Skyslycer/SolarEInk/cad/case_shell.step

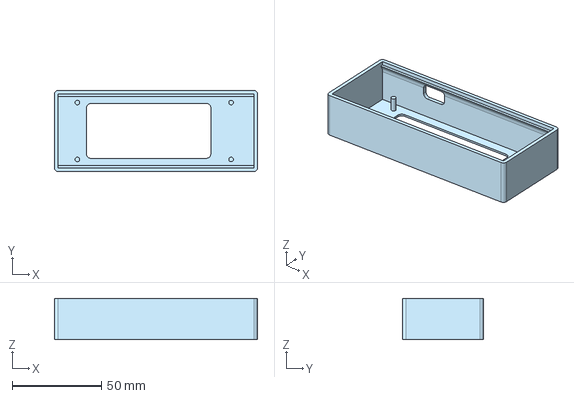
[picture p10: CAD file, 2026-10-25]
cad/case_shell.step
113.7 x 45.5 x 23.0 mm
