Skyslycer/SolarEInk/cad/holder.step

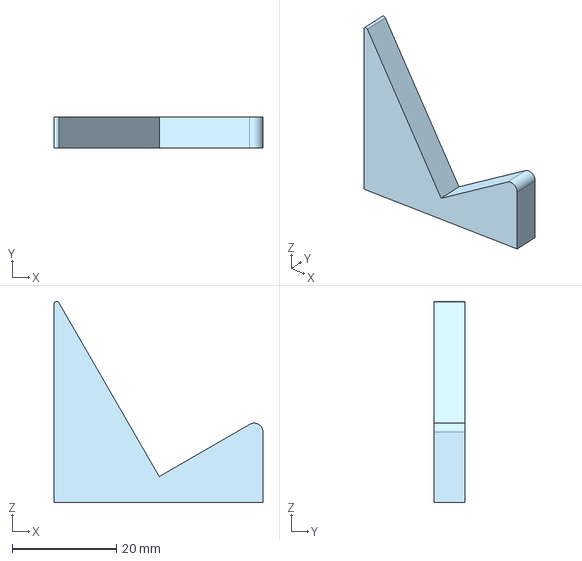
[picture p11: CAD file, 2026-10-25]
cad/holder.step
40.1 x 6.00 x 38.6 mm
