Skyslycer/SolarEInk/cad/case_lid.step

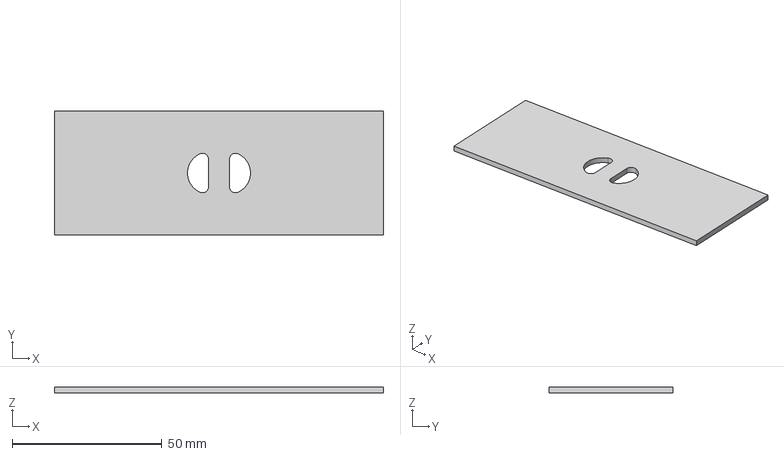
[picture p12: CAD file, 2026-10-25]
cad/case_lid.step
109.7 x 41.5 x 2.00 mm
