Skyslycer/SolarEInk/(list of files, cad)

Other CAD files:
cad/case_lid.stl
cad/case_shell.stl
cad/holder.stl
