Skyslycer/SolarEInk/scripts/generate_fonts.py

"""Generate GFX fonts from explicit pixel glyphs; no font rasterization/resizing.

Each # is an actual screen pixel at 1x. Larger glyphs use exact integer
multiples, preserving symmetric shapes, open counters and even strokes.
0x7f is the degree sign in the dashboard's single-byte text encoding.
"""
from pathlib import Path

patterns = {
    ' ': ['...'] * 7,
    '!': ['#','#','#','#','#','.','#'],
    '%': ['##..#','##..#','...#.','..#..','.#...','#..##','#..##'],
    '-': ['.....','.....','.....','#####','.....','.....','.....'],
    '.': ['.','.','.','.','.','#','#'],
    '/': ['....#','....#','...#.','..#..','.#...','#....','#....'],
    ':': ['.','#','#','.','#','#','.'],
    '?': ['.###.','#...#','....#','...#.','..#..','.....','..#..'],
    '0': ['.###.','#...#','#...#','#...#','#...#','#...#','.###.'],
    '1': ['..#..','.##..','..#..','..#..','..#..','..#..','.###.'],
    '2': ['.###.','#...#','....#','...#.','..#..','.#...','#####'],
    '3': ['####.','....#','....#','.###.','....#','....#','####.'],
    '4': ['...#.','..##.','.#.#.','#..#.','#####','...#.','...#.'],
    '5': ['#####','#....','#....','####.','....#','....#','####.'],
    '6': ['.###.','#....','#....','####.','#...#','#...#','.###.'],
    '7': ['#####','....#','...#.','..#..','.#...','.#...','.#...'],
    '8': ['.###.','#...#','#...#','.###.','#...#','#...#','.###.'],
    '9': ['.###.','#...#','#...#','.####','....#','....#','.###.'],
    'A': ['.###.','#...#','#...#','#####','#...#','#...#','#...#'],
    'B': ['####.','#...#','#...#','####.','#...#','#...#','####.'],
    'C': ['.####','#....','#....','#....','#....','#....','.####'],
    'D': ['####.','#...#','#...#','#...#','#...#','#...#','####.'],
    'E': ['#####','#....','#....','####.','#....','#....','#####'],
    'F': ['#####','#....','#....','####.','#....','#....','#....'],
    'G': ['.###.','#...#','#....','#.###','#...#','#...#','.###.'],
    'H': ['#...#','#...#','#...#','#####','#...#','#...#','#...#'],
    'I': ['###','.#.','.#.','.#.','.#.','.#.','###'],
    'J': ['..###','...#.','...#.','...#.','...#.','#..#.','.##..'],
    'K': ['#...#','#..#.','#.#..','##...','#.#..','#..#.','#...#'],
    'L': ['#....','#....','#....','#....','#....','#....','#####'],
    'M': ['#...#','##.##','#.#.#','#...#','#...#','#...#','#...#'],
    'N': ['#...#','##..#','##..#','#.#.#','#..##','#..##','#...#'],
    'O': ['.###.','#...#','#...#','#...#','#...#','#...#','.###.'],
    'P': ['####.','#...#','#...#','####.','#....','#....','#....'],
    'Q': ['.###.','#...#','#...#','#...#','#.#.#','#..#.','.##.#'],
    'R': ['####.','#...#','#...#','####.','#.#..','#..#.','#...#'],
    'S': ['.####','#....','#....','.###.','....#','....#','####.'],
    'T': ['#####','..#..','..#..','..#..','..#..','..#..','..#..'],
    'U': ['#...#','#...#','#...#','#...#','#...#','#...#','.###.'],
    'V': ['#...#','#...#','#...#','#...#','#...#','.#.#.','..#..'],
    'W': ['#...#','#...#','#...#','#...#','#.#.#','##.##','#...#'],
    'X': ['#...#','#...#','.#.#.','..#..','.#.#.','#...#','#...#'],
    'Y': ['#...#','#...#','.#.#.','..#..','..#..','..#..','..#..'],
    'Z': ['#####','....#','...#.','..#..','.#...','#....','#####'],
    'k': ['#....','#....','#..#.','#.#..','##...','#.#..','#..#.'],
    '\x7f': ['###','#.#','###','...','...','...','...'],
}

out = ['// Generated from original pixel glyphs by scripts/generate_fonts.py.',
       '#pragma once', '#include <Adafruit_GFX.h>']
for name, sx, sy in [('Tiny',1,1), ('Medium',2,2), ('Large',3,3)]:
    data, glyphs = [], []
    for code in range(32,128):
        rows = patterns.get(chr(code), patterns['?'])
        assert len(rows) == 7 and len(set(map(len,rows))) == 1
        bits = []
        for row in rows:
            expanded = [pixel == '#' for pixel in row for _ in range(sx)]
            bits.extend(expanded * sy)
        start = len(data)
        for i in range(0,len(bits),8):
            data.append(sum(0x80 >> j for j,bit in enumerate(bits[i:i+8]) if bit))
        width, height = len(rows[0])*sx, 7*sy
        # One pixel of spacing at every size, so large numeric strings fit
        # without distorting glyph widths or shrinking them to tiny text.
        glyphs.append((start,width,height,width+1,0,-height))
    out += [f'const uint8_t {name}Bits[] PROGMEM = {{']
    out += [','.join(f'0x{x:02x}' for x in data[i:i+24])+',' for i in range(0,len(data),24)]
    out += ['};',f'const GFXglyph {name}Glyphs[] PROGMEM = {{']
    out += ['{'+','.join(map(str,g))+'},' for g in glyphs]
    out += ['};',f'const GFXfont Font{name} PROGMEM = {{(uint8_t*){name}Bits, (GFXglyph*){name}Glyphs, 32, 127, {7*sy+2}}};']
out.append('const GFXfont& FontLabel = FontTiny;')
Path('include/fonts/dashboard_fonts.h').write_text('\n'.join(out)+'\n')
